23septt/Seismoguard/wiki/log.md

# Wiki Activity Log

Chronological record of all Knowledge Architect operations.
Format: `YYYY-MM-DD — <action> — <target(s)> — <source>`

---

- 2026-04-14 — **Initialized** wiki structure (`/raw/`, `/wiki/`, `index.md`, `log.md`) — system bootstrap.
- 2026-04-14 — **Ingested raw artifacts** into `/raw/`: `param_test.js`, `earthquake.ino`, `simulation.ino`, `flowchart_system.png`. Skipped `unpacked/word/document.xml` per user instruction (treated as outdated). — source: project root.
- 2026-04-14 — **Wrote synthesis** `raw/critique_future_work_2026-04-14.md` capturing fresh limitations & future-work bullets supplied by the user (not from the report). — source: chat synthesis.
- 2026-04-14 — **Wrote synthesis** `raw/grid_search_top10_2026-04-14.md` capturing the verbatim grid-search Top-10 table. — source: prior chat run of `param_test.js`.
- 2026-04-14 — **Created** [[STA/LTA Recursive Algorithm]] (`sta-lta-recursive-algorithm.md`) — source: /raw/earthquake.ino, /raw/param_test.js, /raw/grid_search_top10_2026-04-14.md.
- 2026-04-14 — **Created** [[STEAD Dataset]] (`stead-dataset.md`) — source: /raw/grid_search_top10_2026-04-14.md, /raw/critique_future_work_2026-04-14.md.
- 2026-04-14 — **Created** [[Grid Search Optimization]] (`grid-search-optimization.md`) — source: /raw/grid_search_top10_2026-04-14.md, /raw/param_test.js.
- 2026-04-14 — **Created** [[MPU6050 Sensor]] (`mpu6050-sensor.md`) — source: /raw/earthquake.ino, /raw/critique_future_work_2026-04-14.md.
- 2026-04-14 — **Created** [[Characteristic Function (Z-axis)]] (`characteristic-function.md`) — source: /raw/earthquake.ino, /raw/grid_search_top10_2026-04-14.md.
- 2026-04-14 — **Created** [[State Machine]] (`state-machine.md`) — source: /raw/earthquake.ino, /raw/flowchart_system.png.
- 2026-04-14 — **Created** [[Spike Rejection]] (`spike-rejection.md`) — source: /raw/earthquake.ino, /raw/grid_search_top10_2026-04-14.md.
- 2026-04-14 — **Created** [[Project — Earthquake Early Warning Device]] (`project-eew-device.md`) — source: aggregate of /raw/.
- 2026-04-14 — **Created** [[Future Work & Limitations]] (`future-work-limitations.md`) — source: /raw/critique_future_work_2026-04-14.md.
- 2026-04-14 — **Updated** `index.md` to list all 9 atomic pages under their categories.
- 2026-04-15 — **Replaced** `unpacked/word/document.xml` Chapter 5 body (~18.6 KB old) with new content (~19.8 KB) aligned to STEAD+Grid Search results; 21 paragraphs covering สรุปผล, อภิปรายผล (3 headline weaknesses), ข้อเสนอแนะ (5 priorities). Repacked → `รูปเล่มโครงงานเสด_new.docx` (1,760,786 bytes). — source: wiki/future-work-limitations.md, raw/grid_search_top10_2026-04-14.md.
- 2026-04-14 — **Replaced** `unpacked/word/document.xml` sections 2.2.1 and 2.2.2 (old bullet-list style, ~102 KB) with new structured narrative paragraphs (งานวิจัยที่ 1–8, ~31 KB) generated by `build_ch2.js`; repacked → `รูปเล่มโครงงานเสด_new.docx` (1,758,189 bytes). Papers: TH-1 เจริญยุทธ 2550, TH-2 Pananont 2560, TH-3 ชุมชน EEW 2564, FN-4 Won BLESeis 2020, FN-5 Sianturi Arduino MPU6050 2024, FN-6 Mousavi STEAD 2019, FN-7 Mousavi EQTransformer 2020, FN-8 Temneanu Self-Contained 2025.
- 2026-04-14 — **Edited** `unpacked/word/document.xml`: replaced old sections 3.2.6 (threshold test) and 3.2.7 (physical sensitivity test) with new sections 3.2.6 (STA/LTA Recursive algorithm design), 3.2.7 (STEAD data preparation), 3.2.8 (Grid Search optimization). Repacked → `รูปเล่มโครงงานเสด.docx` (1,766,629 bytes).
- 2026-04-15 — **Created** [[IPST Formatting Rules]] (`formatting-ipst-sswt.md`) summarising all สสวท. layout rules from `แบบฟอร์มวิจัย.pdf` (margins, fonts, spacing, page numbers, captions). — source: แบบฟอร์มวิจัย.pdf.
- 2026-04-18 — **Fixed Ch3 equations** via `fix_ch3_equations_v3.js` + `fix_alpha_formula.js`: (1) deleted unused v_y definition paragraph; (2) changed v_x OMML → v̄_z with overline accent; (3) corrected v_z definition text (was "CF = ผลต่างยกกำลังสอง" → "ค่าความเร่งแกน Z อินพุต"); (4) aligned step-3.2.6 step-1 notation (az → v_z/v̄_z); (5) updated STA/LTA recursive formula notation to STA(n)=α·CF(n)+(1−α)·STA(n−1); (6) corrected alpha formula from 1−exp(−1/τ) → 1/(τ·f_s) = 0.04/0.000667 matching firmware. Repacked → `รูปเล่มโครงงานเสด_new.docx` (1,849,500 bytes).
- 2026-04-15 — **Applied formatting** to `unpacked/word/document.xml` + `styles.xml` via `apply_format.js`: (1) page margins all 9 sectPr → left=2160 top=2160 right=1440 bottom=1440 twips; (2) docDefaults paragraph spacing → single (line=240, after=0); (3) Normal style pPr spacing explicit; (4) Normal style rFonts cs=TH Sarabun New added; (5) docDefaults rPrDefault sz 22→32 (16 pt). Repacked → `รูปเล่มโครงงานเสด_new.docx` (1,849,343 bytes).
- 2026-04-18 — **Created** `roc_analysis.js`: sweeps RATIO 10.0→1.5 (86 points), computes TPR/FPR/F1/AUC on STEAD 77P+38N; outputs ASCII ROC plot + `roc_data.csv`. AUC=0.9737; best operating point RATIO=5.0 (TPR=100%, FPR=3%, F1=0.994, avgDelay=11.1 samples). — source: param_test.js logic, seismoguard_data.json.
- 2026-04-18 — **Created** `adaptive_threshold.js`: Percentile Adaptive Threshold (PAT) benchmark vs fixed RATIO=5.0. PAT params: QUIET_BUF=200, PERC_Q=0.99, PERC_K=2.0, BASE=3.0. Cold-start results: Fixed TPR=100%/FPR=3%/F1=0.994; PAT TPR=36%/FPR=0%/F1=0.533. Documents warm-start advantage and ESP32 firmware hint. — source: roc_analysis.js, seismoguard_data.json.
- 2026-04-18 — **Created** `pd_magnitude.js`: Pd peak-displacement magnitude estimation on 77 P-wave waveforms. Pipeline: 3s window → detrend → integrate (trapezoidal) → detrend linear → integrate → peak abs disp → Wu & Kanamori (2005) log10(M)=1.0×log10(Pd)+5.39. Results: Mw range 3.34–8.88, median 5.20. — source: seismoguard_data.json, Wu & Kanamori 2005.
- 2026-04-18 — **Created** `seismoguard_esp32.ino`: full ESP32 port with (1) 50Hz hardware timer ISR; (2) WiFi connect; (3) HTTPS LINE Notify alert with Mw estimate; (4) Pd buffer 150×float; (5) local buzzer/LED; (6) 30s alert cooldown; (7) heartbeat serial monitor. Algorithm identical to Arduino version (τ_STA=0.5s, RATIO=5.0, MIN=10, SPIKE=100). — source: earthquake.ino, pd_magnitude.js.
- 2026-04-18 — **Created** [[ROC Analysis]] (`roc-analysis.md`). — source: roc_analysis.js output.
- 2026-04-18 — **Created** [[Adaptive Threshold]] (`adaptive-threshold.md`). — source: adaptive_threshold.js.
- 2026-04-18 — **Created** [[Pd Magnitude Estimation]] (`pd-magnitude.md`). — source: pd_magnitude.js, Wu & Kanamori 2005.
- 2026-04-18 — **Created** [[ESP32 LINE Notify Firmware]] (`esp32-line-notify.md`). — source: seismoguard_esp32.ino.
- 2026-04-18 — **Updated** `index.md`: added 3 algorithm pages (ROC, Adaptive Threshold, Pd) + 1 hardware page (ESP32 LINE Notify) under correct categories.
- 2026-04-19 — **Upgraded** `adaptive_threshold.js` → v2: added "preload pass" — silently scan first 50 pre-onset samples to populate quiet buffer before detection loop, fixing cold-start TPR (was 36% in v1). Swept PERC_K 1.0→2.5; best trade-off: PERC_K=1.2 (TPR=84%/FPR=3%/F1=0.909) or PERC_K=1.5 (TPR=74%/FPR=0%/F1=0.851) for zero-FP urban deployment. — source: seismoguard_data.json.
- 2026-04-19 — **Updated** [[Adaptive Threshold]] (`adaptive-threshold.md`): replaced v1 single-row result table with full v2 PERC_K sweep table (16 rows), added v1→v2 comparison, updated recommended PERC_K 2.0→1.5, corrected firmware hint multiplier. — source: adaptive_threshold.js v2 output.
- 2026-04-19 — **Created** `adaptive_sweep2d.js`: 3-D grid search QUIET_BUF_SIZE×PERC_K×PERC_Q (6×16×3=288 combos). Key finding: QUIET_BUF_SIZE=25 (matches 50-sample preload → fully populated ×2) improves best cold-start F1 from 0.909 → **0.939** (TPR=90%/FPR=3%) and best zero-FP F1 from 0.851 → **0.900** (TPR=82%). Recommended params: bufSize=25, PQ=0.99, PK=1.1. — source: seismoguard_data.json.
- 2026-04-19 — **Updated** [[Adaptive Threshold]] (`adaptive-threshold.md`): added 2D-sweep results table, buffer-size insight, updated firmware snippet (bufSize 200→25, PK 1.5→1.1, memory 400B→50B). — source: adaptive_sweep2d.js output.
- 2026-04-19 — **Re-validated all algorithms** on stratified dataset (200P+100N, Mw bins 3–4/4–5/5–6/6+ × 50 each). ROC: AUC=0.9689 (was 0.9737), RATIO=5.0 → TPR=94%/FPR=1%/F1=0.964/delay=14.7smp. PAT 2D sweep: best zero-FP = bufSize=50/PQ=0.99/PK=1.1 → TPR=82%/F1=0.898. — source: roc_analysis.js, adaptive_sweep2d.js, adaptive_threshold.js.
- 2026-04-19 — **Updated** `seismoguard.html`: ROC stats (AUC 0.9737→0.9689, TPR 100%→94%, FPR 3%→1%, F1 0.994→0.964, delay 11.1→14.7 smp), dataset counts (77→200 P-wave, 38→100 noise, label counters updated).
- 2026-04-19 — **Updated** `roc_analysis.js` + `adaptive_threshold.js`: comments N_PWAVE 77→200, N_NOISE 38→100; adaptive conclusion updated to PERC_K=1.1 bufSize=50.
- 2026-04-19 — **Updated** [[ROC Analysis]] (`roc-analysis.md`): full new results table, old-vs-new comparison, updated interpretation.
- 2026-04-19 — **Updated** [[Adaptive Threshold]] (`adaptive-threshold.md`): new 2D benchmark table (bufSize=50 confirmed optimal), firmware buf 25→50 (100 bytes DRAM).
- 2026-04-19 — **Updated** `index.md`: STEAD, ROC, Adaptive Threshold entries reflect stratified 200+100 dataset.
- 2026-04-19 — **Re-ran grid search** (`param_test.js`) on 200P+100N stratified dataset. Expanded grid: STA∈[0.2–0.6], RATIO∈[3.0–6.0], MIN∈[3–15], SPIKE∈[20–200] = 980 combos. New optimal: RATIO=4.0, MIN=5, SPIKE=50, STA=0.5s → TPR=96%/FPR=2%/F1=0.972/delay=9.6smp (vs old: 94%/1%/0.964/14.7smp). F1 +0.008, delay -5.1 samples.
- 2026-04-19 — **Updated firmware params** in `earthquake.ino` + `seismoguard_esp32.ino`: RATIO 5.0→4.0, MIN_TRIG 10→5, SPIKE 100→50.
- 2026-04-19 — **Updated** `seismoguard.html`: slider defaults (RATIO 5.0→4.0, MIN 10→5, SPIKE 100→50), JS _defaults(), ROC stats (TPR 94%→96%, FPR 1%→2%, F1 0.964→0.972, delay 14.7→9.6 smp).
- 2026-04-19 — **Implemented 2-tier alert** in `earthquake.ino` + `seismoguard_esp32.ino`: added MW_ALERT_LOCAL=4.5 / MW_ALERT_LINE=5.0 thresholds; added Pd estimation to Arduino (75-sample in-place buffer, 300 bytes SRAM); sub-threshold Mw<4.5 detected silently, no buzzer; LINE notify only at Mw≥5.0 with urgency-scaled message (5.0, 5.5, 6.0 tiers).
- 2026-04-19 — **Restructured** `stead_extractor.py` MW bins to align with alert tiers: sub(3–4.5)×100, T1(4.5–5)×100, T2(5–6.5)×200, crit(6.5+)×100 = 500P + 250N.
- 2026-04-19 — **Created** `stead_extractor.py`: Kaggle notebook to re-extract seismoguard_data.json from STEAD. Fixes: (1) Z-axis only data[:,2] not vector magnitude; (2) downsample 100→50 Hz via [::2]; (3) correct window sizes P=300 (50+250), Noise=2000 (1750+250); (4) JSON output not Arduino arrays. Dataset: https://www.kaggle.com/datasets/isevilla/stanford-earthquake-dataset-stead
- 2026-04-20 — **Updated** `stead_extractor.py`: restructured MW_BINS to 500P target aligned to 2-tier alert (sub 3–4.5×100, T1 4.5–5×100, T2 5–6.5×200, crit 6.5+×100) + N_NOISE=250. Removed legacy N_PWAVE/N_NOISE=100 constants. Ran on Kaggle → got 439P (crit bin limited to 39 by STEAD coverage) + 250N.
- 2026-04-20 — **Re-ran grid search** (`param_test.js`) on 439P+250N stratified dataset. New optimal: RATIO=6.0, MIN=3, SPIKE=50, STA=0.5s → TPR=100%/FPR=1%/F1=0.995/delay=11.6smp (vs old 200P+100N: 96%/2%/0.972/9.6smp).
- 2026-04-20 — **Re-ran ROC analysis** (`roc_analysis.js`) on 439P+250N. AUC=0.9919 (was 0.9689). RATIO=6.0 operating point: TPR=100%/FPR=1%/F1=0.994/delay=17.4smp (ROC sweep). Best F1=0.994 at RATIO=5.7.
- 2026-04-20 — **Re-ran adaptive sweep** (`adaptive_sweep2d.js`) on 439P+250N. Best zero-FP: bufSize=25/PQ=0.99/PK=1.2 → TPR=89%/F1=0.941. Best FPR≤3%: bufSize=25/PQ=0.95/PK=1.2 → TPR=94%/F1=0.964.
- 2026-04-20 — **Updated firmware params** in `earthquake.ino` + `seismoguard_esp32.ino`: RATIO 4.0→6.0, MIN_TRIG 5→3.
- 2026-04-20 — **Updated** `seismoguard.html`: dataset counts (200P→439P, 100N→250N), ROC stats (AUC 0.9689→0.9919, TPR 96%→100%, FPR 2%→1%, F1 0.972→0.995, delay 9.6→11.6smp), slider defaults (RATIO 4.0→6.0, MIN 5→3).
- 2026-04-20 — **Updated** [[ROC Analysis]] (`roc-analysis.md`): new results table, comparison v1/v2/v3 dataset, updated deployed RATIO 5.0→6.0.
- 2026-04-20 — **Updated** [[Adaptive Threshold]] (`adaptive-threshold.md`): new 439P+250N benchmark table, best bufSize 50→25, zero-FP F1 0.898→0.941, firmware snippet updated.
- 2026-04-20 — **Fixed** `adaptive_sweep2d.js` + `adaptive_threshold.js` + `roc_analysis.js`: updated MIN_TRIG 10→3, SPIKE 100→50 to match grid-search optimal. Re-ran all three. New adaptive sweep results: zero-FP best = bufSize=200/PQ=0.95/PK=1.6 → TPR=85%/F1=0.917; best FPR≤4% = bufSize=25/PQ=0.99/PK=1.1 → TPR=93%/F1=0.958.
- 2026-04-20 — **Fixed** `param_test.js` comment: "200P+100N" → "439P+250N", updated previous-defaults comparison to RATIO=4.0/MIN=5/SPIKE=50.
- 2026-04-20 — **Rewrote** [[Grid Search Optimization]] (`grid-search-optimization.md`): replaced 77P+38N era top-10 table with v3 (439P+250N) top-10, version history table, caveats updated.
- 2026-04-20 — **Updated** [[Adaptive Threshold]] (`adaptive-threshold.md`): PERC_K sweep table rewritten with 439P+250N results; 2D-sweep best params updated (zero-FP: bufSize=200/PK=1.6/PQ=0.95 → F1=0.917); firmware snippet updated.
- 2026-04-20 — **Updated** [[STA/LTA Recursive Algorithm]] (`sta-lta-recursive-algorithm.md`): operating params RATIO 5.0→6.0, MIN 10→3, added SPIKE=50, F1 updated to 0.995. — source: grid search v3.
- 2026-04-20 — **Updated** [[ESP32 LINE Notify Firmware]] (`esp32-line-notify.md`): params table RATIO 5.0→6.0, MIN_TRIG 10→3, SPIKE 100→50; AUC 0.9737→0.9919; serial output RATIO updated; differences table Pd/2-tier rows updated. — source: seismoguard_esp32.ino v3.
- 2026-04-20 — **Rewrote** [[STEAD Dataset]] (`stead-dataset.md`): v3 dataset table (sub×100, T1×100, T2×200, crit×39, Noise×250), version history v1/v2/v3, Pd overestimation limitation noted. — source: stead_extractor.py output.
- 2026-04-20 — **Rewrote** [[Project — Earthquake Early Warning Device]] (`project-eew-device.md`): pipeline SPIKE 100→50; per-bin detection table (all 4 Mw bins); Pd per-bin validation table; critical limitation (91% sub-bin overestimate) documented. — source: roc_analysis.js, pd_magnitude.js v3.
- 2026-04-21 — **Rewrote Ch4 sections 4.4–4.7** in `รูปเล่มโครงงานเสด_new.docx` via `build_ch4.js` (88 KB new, replacing 37 KB old): 4.4 Grid Search v3 top-10 table (RATIO=6.0/MIN=3/SPIKE=50, F1=0.995, 980 combos, 677,220 sims); 4.5 ROC Analysis AUC=0.9919 key-points table; 4.6 Pd per-bin estimation table (crit 97% correct, sub 79% overestimate); 4.7 2-tier alert summary table. XML-escaped all < > & in table cells. — source: grid-search-optimization.md, roc-analysis.md, project-eew-device.md.
- 2026-04-21 — **Updated Ch5 body** in `รูปเล่มโครงงานเสด_new.docx` via `build_ch5_v2.js` (21 KB new, replacing 69 KB old): 5.1 results updated (77/77→439/439, 225→980 combos, RATIO=5.0→6.0, MIN=10→3, SPIKE=100→50, delay 11.1→11.6smp, FP 1/38→3/250 1%, AUC=0.9919 added, Pd limitation added); 5.2 discussion updated (Spike factor 100→50, MIN 10→3, FPR 2.6→1%, single-station limitation added); 5.3 recommendations reordered (field test first priority, Pd calibration added as req. 2). — source: all v3 results.
- 2026-04-21 — **Updated Ch3 Grid Search paragraphs** in `รูปเล่มโครงงานเสด_new.docx`: para-1 (search space 225→980 combos, STEAD 115→689 traces, 25,875→677,220 simulations); para-2 (best params RATIO=5.0→6.0, MIN=10→3, SPIKE=100→50, delay 11.1→11.6smp, FA 1/38 2.6%→3/250 1%, F1=0.995 added). — direct XML replacement at para offsets 381037–383579.
- 2026-04-21 — **Updated Ch2 STEAD references** (×2) in `รูปเล่มโครงงานเสด_new.docx`: (1) section 2.1.6 STEAD description: 77P+38N→439P+250N, 25,875→677,220 sims via `fix_ch2_stead.js`; (2) literature review paper-6 summary paragraph: same values plus Stratified Mw bins added via `fix_ch2_stead2.js`. All v1 data (25,875, 77/77, 1/38 2.6%, MIN=10, SPIKE=100, 225 combos) now completely removed from the document. Final doc size: 875,515 bytes.
- 2026-04-21 — **Replaced Pd-based tier logic with peak STA/LTA ratio-based tier logic** in both firmware files. Root cause: MPU6050 noise floor ~400× higher than broadband seismometers; double integration amplifies noise until it exceeds real signal displacement for Mw <5 events — Pd estimate is unreliable. Fix: use peakRatio (max STA/LTA during ALARMING window) as shaking-intensity proxy — already computed, no integration needed, self-normalized to local noise. Changes: (1) `raw/earthquake.ino`: removed MW_ALERT_LOCAL, PD_SAMPLES, MPU_SCALE_CMS2, WK_INTERCEPT, pdBuf[75] (freed 300 bytes SRAM), pdIdx, pdCollecting, computeMw(); added RATIO_TIER1=8.0f, peakRatio global, immediate arming when peakRatio >= RATIO_TIER1; (2) `seismoguard_esp32.ino`: removed MW_ALERT_LOCAL + MW_ALERT_LINE, added RATIO_TIER1=8.0f + RATIO_TIER2=25.0f, added peakRatio + lineSent globals, Tier-1 and Tier-2 fire immediately (no 3s wait), kept computeMw() for informational Serial.printf logging only. RATIO_TIER1/TIER2 are initial estimates — require field calibration with real earthquake data.
