23septt/Seismoguard/CDT2026/seismoguard_uno_q/tests/fixtures/synthetic_pwave.csv

# synthetic P-wave-like waveform | 100 Hz | 5 s total
# format: ax_mss | ay_mss | az_mss
# 100 quiet samples (1 s) | then 400 samples (4 s) of damped 3 Hz envelope on Z
0.0 | 0.0 | 9.81
0.0 | 0.0 | 9.81
0.0 | 0.0 | 9.81
0.0 | 0.0 | 9.81
0.0 | 0.0 | 9.81
0.0 | 0.0 | 9.81
0.0 | 0.0 | 9.81
0.0 | 0.0 | 9.81
0.0 | 0.0 | 9.81
0.0 | 0.0 | 9.81
0.0 | 0.0 | 9.81
0.0 | 0.0 | 9.81
0.0 | 0.0 | 9.81
0.0 | 0.0 | 9.81
0.0 | 0.0 | 9.81
0.0 | 0.0 | 9.81
0.0 | 0.0 | 9.81
0.0 | 0.0 | 9.81
0.0 | 0.0 | 9.81
0.0 | 0.0 | 9.81
0.0 | 0.0 | 9.81
0.0 | 0.0 | 9.81
0.0 | 0.0 | 9.81
0.0 | 0.0 | 9.81
0.0 | 0.0 | 9.81
0.0 | 0.0 | 9.81
0.0 | 0.0 | 9.81
0.0 | 0.0 | 9.81
0.0 | 0.0 | 9.81
0.0 | 0.0 | 9.81
0.0 | 0.0 | 9.81
0.0 | 0.0 | 9.81
0.0 | 0.0 | 9.81
0.0 | 0.0 | 9.81
0.0 | 0.0 | 9.81
0.0 | 0.0 | 9.81
0.0 | 0.0 | 9.81
0.0 | 0.0 | 9.81
0.0 | 0.0 | 9.81
0.0 | 0.0 | 9.81
0.0 | 0.0 | 9.81
0.0 | 0.0 | 9.81
0.0 | 0.0 | 9.81
0.0 | 0.0 | 9.81
0.0 | 0.0 | 9.81
0.0 | 0.0 | 9.81
0.0 | 0.0 | 9.81
0.0 | 0.0 | 9.81
0.0 | 0.0 | 9.81
0.0 | 0.0 | 9.81
0.0 | 0.0 | 9.81
0.0 | 0.0 | 9.81
0.0 | 0.0 | 9.81
0.0 | 0.0 | 9.81
0.0 | 0.0 | 9.81
0.0 | 0.0 | 9.81
0.0 | 0.0 | 9.81
0.0 | 0.0 | 9.81
0.0 | 0.0 | 9.81
0.0 | 0.0 | 9.81
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
