23septt/Seismoguard/Data/roc_results.csv

ratio | tpr | fpr | precision | f1 | tp | fp | avg_delay_samples
10.0 | 0.9841 | 0.0080 | 0.9954 | 0.9897 | 432 | 2 | 15.52
9.9 | 0.9841 | 0.0080 | 0.9954 | 0.9897 | 432 | 2 | 15.43
9.8 | 0.9841 | 0.0080 | 0.9954 | 0.9897 | 432 | 2 | 15.18
9.7 | 0.9841 | 0.0080 | 0.9954 | 0.9897 | 432 | 2 | 15.09
9.6 | 0.9841 | 0.0080 | 0.9954 | 0.9897 | 432 | 2 | 14.87
9.5 | 0.9841 | 0.0080 | 0.9954 | 0.9897 | 432 | 2 | 14.42
9.4 | 0.9841 | 0.0080 | 0.9954 | 0.9897 | 432 | 2 | 14.19
9.3 | 0.9841 | 0.0080 | 0.9954 | 0.9897 | 432 | 2 | 14.12
9.2 | 0.9841 | 0.0080 | 0.9954 | 0.9897 | 432 | 2 | 14.02
9.1 | 0.9841 | 0.0080 | 0.9954 | 0.9897 | 432 | 2 | 13.93
9.0 | 0.9841 | 0.0080 | 0.9954 | 0.9897 | 432 | 2 | 13.82
8.9 | 0.9841 | 0.0080 | 0.9954 | 0.9897 | 432 | 2 | 13.70
8.8 | 0.9841 | 0.0080 | 0.9954 | 0.9897 | 432 | 2 | 13.60
8.7 | 0.9863 | 0.0080 | 0.9954 | 0.9908 | 433 | 2 | 13.86
8.6 | 0.9863 | 0.0080 | 0.9954 | 0.9908 | 433 | 2 | 13.77
8.5 | 0.9863 | 0.0080 | 0.9954 | 0.9908 | 433 | 2 | 13.69
8.4 | 0.9863 | 0.0080 | 0.9954 | 0.9908 | 433 | 2 | 13.63
8.3 | 0.9863 | 0.0080 | 0.9954 | 0.9908 | 433 | 2 | 13.55
8.2 | 0.9863 | 0.0080 | 0.9954 | 0.9908 | 433 | 2 | 13.45
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
