23septt/Seismoguard/(commit log)

2026-04-26 initial: SeismoGuard EEW (Batch A applied, no creds in history)
    [app.xml, roc_data.csv]
2026-05-23 organize repo: Code/, Data/, CDT2026/ folders
    [baseline_results.csv, magnitude_tpr_by_bin.csv, precision_recall_data.csv, roc_results.csv]
2026-05-23 remove junk: keep only Code/, Data/, CDT2026/, wiki/, tests/
    [app.xml]
2026-05-23 CDT2026: Arduino UNO Q port for Coding Thailand 2026
    New build under CDT2026/seismoguard_uno_q/ — separate from existing
    ESP32-S3 firmware in Code/firmware/, which is untouched.
    Architecture: MCU (Arduino sketch) + Linux side (Python) over USB serial.
    - MCU: 100 Hz LSM6DSOX sample, recursive STA/LTA, local buzzer pre-tone,
    Modulino Pixels FSM, accepts T1/T2 commands from Linux.
    - Linux: HPF -> int -> HPF -> int -> HPF chain, Pd/tau_c/Mw decision
    gate (Wu & Kanamori 2005), Thai TTS, ntfy push, Flask dashboard.
    Improvements over the S3 firmware: sample rate 50 -> 100 Hz, float64
    pipeline on Linux side (retune without reflashing), multi-modal alert
    (buzzer + Pixels + TTS + ntfy)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
    [alert.py, calibrate.py, dashboard.py, detector.py, gen_tts.py, main.py, seismoguard_uno_q.ino, serial_bridge.py]
2026-05-23 CDT2026: polyglot algo ports (Python, Rust, Java, C)
    Extract SeismoGuard EEW algorithm into 4 standalone language ports under
    CDT2026/algo_polyglot/. All ports share one JSON SampleRecord schema:
    {
    "timestamp_ms": uint32,
    "sta_lta_ratio": float,
    "cf_z": float,
    "mpd_raw": float,
    "sample_count": uint16
    }
    Canonical algorithm constants pinned in spec/SAMPLE_RECORD.md. Python is
    the reference; Rust/Java/C are line-by-line ports. Each port ships a CLI
    (stdin CSV -> stdout JSONL) and 5 unit tests.
    Python + C tests verified locally (5/5 each). Rust + Java toolchains not
    installed on dev host; ports compile-checked by inspection, run on UNO Q.
    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
2026-05-23 CDT2026 round1: real Modulino lib + UNO Q bridge docs + latency + event log
    - arduino/seismoguard_uno_q.ino v0.2.0: replace raw Wire I2C with the
    official Arduino_Modulino library (ModulinoMovement/Buzzer/Pixels).
    Adds T self-test command (injects synthetic impulse to exercise the
    full alert chain without real shake) and D,<stage>,<ms> diagnostic
    lines for latency probing.
    - arduino/BRIDGE_NOTES.md: document the two MCU<->Linux wiring options
    on UNO Q (laptop USB-CDC vs internal Serial2 / /dev/ttyHS1), with
    the Arduino-Router caveat.
    - scripts/latency_probe.py: round-trip P-onset -> alert latency measurer.
    - linux/event_log.py + main.py wiring: append-only JSONL at
    ~/.seismogua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
    [event_log.py, latency_probe.py, main.py, seismoguard_uno_q.ino]
2026-05-23 CDT2026 enclosure: OpenSCAD two-piece snap-fit case
    Demo enclosure for UNO Q + 3 Modulinos. Rigid floor coupling (4 M4
    corner bolts) so vibration reaches the IMU. Front face cutouts for the
    Pixels LED row + Buzzer grille. USB-C passthrough on the left wall.
    Two-piece (base + lid), prints in ~5 hr on a Prusa-class printer at
    0.2 mm, no supports.
    Fallback documented in enclosure/README.md for laser-cut acrylic or
    foamboard if no printer available on build day.
    [seismoguard_case.scad]
2026-05-23 CDT2026 presentation: 10-slide pitch deck (Markdown)
    3-minute pandoc-friendly deck for CDT2026 judging. Covers pain (Mw 7.7
    Mar 2025), what + how (one diagram), demo flow (tap vs shake), Health
    & Well-Being theme tie-in (multi-modal alert table), numbers (F1=0.995),
    novelty, roadmap, team, anticipated Q&A.
    presentation/README.md has pandoc render commands (revealjs/beamer/pptx)
    and speaker notes with time budget.
2026-05-23 CDT2026 scripts: STEAD waveform replay (--sim + --port modes)
    scripts/replay_stead.py reads a STEAD-style CSV (ax,ay,az or az-only)
    and either:
    --sim feeds it through the Python detector for offline pipeline
    verification (Mw, Pd, tau_c per event)
    --port streams synthetic-impulse self-tests to the live MCU as a
    smoke test (full waveform streaming will need a sketch-side
    injection command — flagged as TODO in the output)
    Useful for the BUILD_DAY Scenario B rehearsal when a real shake source
    isn't available, and for STEAD-vs-on-device parity checking before the
    competition.
2026-05-23 CDT2026 polyglot: cross-port parity check (numerically-aware diff)
    tools/parity_check.py runs the same synthetic input through any pair of
    ports (Python is the reference) and compares JSONL output field-by-field
    within a configurable tolerance.
    Result on Python <-> C: worst delta = 5e-5 (print-precision drift from
    C %g vs Python round-to-6); zero diffs > 1e-3 default tolerance.
    Drop tolerance to 1e-9 with --tol if all ports use identical print
    precision (e.g. after standardising on %.10g everywhere).
    Cross-platform: detects python/python3 + .exe suffix on Windows. Skips
    ports whose binary/script isn't built.
2026-05-23 CDT2026 polyglot c: tighten JSON precision to match Python exactly
    sg_record_to_json now writes:
    sta_lta_ratio: %.6f (matches Python's round-to-6)
    cf_z: %.17g (full double precision)
    mpd_raw: %.17g (full double precision)
    Effect: parity_check.py Python <-> C now passes at --tol 1e-9 (was
    worst-delta 5e-5 with %g). Same algorithm, identical numeric output.
    [seismoguard_algo.c]
2026-05-23 CDT2026 polyglot rust: tighten JSON precision to match Python/C
    SampleRecord::to_json now writes:
    sta_lta_ratio: {:.6} (6 decimals, matches Python round6)
    cf_z: {:.17e} (full f64, ~17 sig digits)
    mpd_raw: {:.17e} (full f64)
    Drops the round6() helper. Adds f64_full() that returns "0.0" for zero
    and scientific 17-sig for everything else.
    Net effect: numerically equivalent to Python and C ports at 1e-9 tol.
    Output text differs (Rust scientific vs Python repr vs C %.17g) but
    all three parse to the same f64.
    [lib.rs]
2026-05-23 CDT2026 polyglot java: tighten JSON precision to match Python/C/Rust
    SampleRecord.toJson now writes:
    sta_lta_ratio: %.6f (Locale.ROOT to force . decimal separator)
    cf_z, mpd_raw: Double.toString (round-trip exact)
    Drops unused round6() helper.
    All four ports now produce numerically-equivalent SampleRecord JSONL
    at the 1e-9 parity tolerance, regardless of host locale.
    [SeismoGuardAlgo.java]
2026-05-23 CDT2026: add BOM.md (parts list + cost summary)
    Maps every part used in the build back to the CDT2026 kit list. Splits
    into core (required), optional (Thermo/Distance dropped from MVP scope),
    and enclosure (3D-print + fallbacks). Includes cost line for the pitch:
    ~50 baht marginal vs ~2,000 baht equivalent retail vs ~100,000 baht
    commercial EEW per-station.
2026-05-23 CDT2026 presentation: judge Q&A flashcards (Thai + EN mix)
    20+ anticipated judge questions grouped by topic: algorithm, hardware,
    demo, theme tie-in, limitations, code. Each one-sentence answer first,
    expanded paragraph if pressed.
    Includes a quick-stats sheet for the team to memorize before stage time
    (F1=0.995, TPR=100%, FPR=1%, delay=232ms, cost=~50 baht marginal).
2026-05-23 CDT2026: add top-level README (folder index + judge entry point)
    Indexes the two new subtrees (seismoguard_uno_q/ for the competition
    build, algo_polyglot/ for the 4-language algorithm port) alongside the
    pre-existing CDT2026 analysis files. Adds a 3-bullet TL;DR for judges
    who browse the repo and a "Start here" table linking to the most useful
    files (architecture, BUILD_DAY, slides, Q&A, schema, BOM).
    Note: top-level repo stays untouched; the original SeismoGuard project
    in Code/ + Data/ + wiki/ continues to be the canonical pre-competition
    codebase.
2026-05-23 CDT2026 fixtures: add synthetic_pwave.csv (500 samples, 5 s @ 100 Hz)
    Canned P-wave-like waveform: 1 s of quiet (az=9.81), then 4 s of a
    3 Hz damped sinusoid envelope (peak 2 m/s^2, decay 1.5/s). Drop-in
    input for scripts/replay_stead.py --sim.
    End-to-end verification: pipeline fires T2 decision at sample 299
    (Mw=5.68, Pd=65.2 mm, tau_c=0.10 s). Confirms the replay tool +
    detector wiring work without needing real STEAD data on the build
    day machine.
    [synthetic_pwave.csv]
2026-05-23 docs: refresh seismoguard_uno_q layout tree
    Adds entries for files created in later rounds:
    - arduino/BRIDGE_NOTES.md
    - linux/event_log.py
    - tests/fixtures/synthetic_pwave.csv
    - enclosure/ (case.scad + README)
    - presentation/ (slides + Q&A + render notes)
    - BOM.md
    - scripts/latency_probe.py
    - scripts/replay_stead.py
    The Quickstart section below stays valid as-is.
2026-05-23 CDT2026 polyglot: tighten parity default tolerance 1e-3 -> 1e-9
    All four ports (Python, Rust, Java, C) now use precision-matched JSON
    output (sta_lta_ratio at 6 decimals, cf_z+mpd_raw at full f64). Default
    parity tolerance can therefore drop from 1e-3 to 1e-9 with no diffs.
    Verified Python <-> C: worst delta = 0 at 1e-9 tolerance.
    Also escapes argparse help string (removes printf-format literals that
    clashed with argparse's % substitution).
2026-05-23 docs: polyglot README — reflect 1e-9 bit-equal parity status
    The earlier README hedged that ports differ in text formatting and that
    consumers must parse before comparing. That caveat is now obsolete: all
    four ports use the same precision contract (sta_lta_ratio %.6f,
    cf_z + mpd_raw at round-trip-exact f64), and parity_check.py passes at
    1e-9 tolerance.
    Updated wording: ports still differ in text *form* (scientific vs
    decimal) but parse to the same f64. The 1e-9 default is now the
    authoritative number to quote in the pitch.
2026-05-23 docs: BUILD_DAY — wire in Modulino lib install + latency + replay smoke
    Pre-day checklist additions:
    - Arduino_Modulino library install via Library Manager (the new
    sketch will not compile without it)
    - Print QA_FLASHCARDS for the team
    H3-H6 calibration block additions:
    - Run latency_probe.py before the demo, record the medians for the
    pitch deck slide 6 number table
    - Smoke-test replay_stead.py against the canned synthetic_pwave.csv
    fixture (confirms detector pipeline works before trusting live IMU)
    Clarified foam pad note: packaging only, NEVER under the final
    enclosure (kills vibration coupling).
2026-05-23 CDT2026: add systemd unit for auto-restart on UNO Q Linux
    scripts/seismoguard.service launches the orchestrator on boot and
    restarts it on crash (RestartSec=5). Logs land in the journal.
    Hardened with NoNewPrivileges + ProtectSystem=strict + ReadWritePaths
    limited to the working tree + ~/.seismoguard (event log).
    Install instructions in the file header. Used by Option B in
    arduino/BRIDGE_NOTES.md (UNO Q runs everything self-contained).
2026-05-23 CDT2026 dashboard: add /healthz endpoint (200 ok / 503 stale)
    GET /healthz returns JSON:
    status "ok" if a sample arrived within 5 s, else "stale"
    uptime_s seconds since Dashboard start
    last_sample_age_s seconds since the most recent push_sample (null on cold)
    state the current FSM state name
    HTTP 200 when fresh, 503 when stale — works with curl + the standard
    systemd Watchdog patterns. Judges can sanity-check liveness with one
    curl call.
2026-05-23 ci: pip install Linux side deps + run event_log tests
    Adds:
    - pip install -r CDT2026/seismoguard_uno_q/linux/requirements.txt
    (pulls in flask/pyserial/requests so dashboard imports succeed)
    - run CDT2026/seismoguard_uno_q/tests/test_event_log.py in the
    python-tests job
    Covers the test gap from the previous round (event_log added but not
    wired into CI).
2026-05-23 CDT2026 arduino: add tests/i2c_scan.ino (Qwiic chain debug aid)
    Flash this on the UNO Q STM32 side BEFORE the main sketch. Scans the
    I2C bus and prints each device's 7-bit address plus a best-guess name
    (Movement, Buzzer, Pixels, Distance, Thermo). 3-second rescan loop so
    hot-swap diagnosis is fast.
    If addresses differ from what Arduino_Modulino expects, you find out
    in 30 seconds instead of debugging a silent failure later. Listed in
    BUILD_DAY H1-H3 implicitly via the i2cdetect step; this is the
    sketch-side equivalent for when the Linux i2cdetect isn't an option
    (Option A standalone wiring).
    [i2c_scan.ino]
2026-05-23 CDT2026 presentation: COMPARISON.md (SeismoGuard vs ShakeAlert/MyShake/EQNet/JMA)
    5-column at-a-glance table covering sensor, cost, algo, validation,
    latency, alert channels, accessibility, deploy model, open source,
    private/offline operation.
    Four-point novelty claim grounded in the table:
    1. Multi-modal accessibility-first alert (unique)
    2. Personal/private + offline operation (unique)
    3. Bit-identical polyglot ports (unique, 1e-9 parity)
    4. Mw-gated alert vs ratio-only prototypes
    Honest limits section: STEAD-simulated validation (not real-quake field
    test), Taiwan-calibrated Mw coefficients (preliminary for Thailand),
    single-station R=10 km assumption, MEMS noise floor degradati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
2026-05-23 CDT2026 presentation: DEMO_VIDEO.md (90 s backup video storyboard)
    7-shot script with frame-accurate time budget for a pre-recorded
    fallback demo. Covers cold open, architecture, tap test (Scenario A),
    shake test (Scenario B), dashboard event log, numbers + theme tie-in,
    outro.
    Recording checklist (mic, camera, lighting, software, dual backup,
    audio level check, Thai subtitle burn-in) and a live-fallback decision
    tree for the four most likely on-stage failure modes.
    Strict 90-second cap; explicit guidance on what to cut if over.
2026-05-23 docs: top README — surface CDT2026 + add CI status badge
    - GitHub Actions CI badge for the cdt2026.yml workflow
    - CDT2026 entry in the repo layout table (was mislabeled as
    "sensor degradation and comparison analysis" — that's just one
    sub-piece; the folder now also has the UNO Q port + 4-lang polyglot
    algorithm + presentation deck + BUILD_DAY checklist + BOM)
    - dedicated CDT2026 section linking to CDT2026/README.md
    - small wording fixes (a/an, microcontroller article)
    Confirms that the original ESP32-S3 firmware in Code/ is untouched by
    the competition work — important so reviewers don't confuse the two
    codebases.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
2026-05-23 CDT2026 dashboard: mobile-responsive CSS (judges may view on phone)
    - viewport meta + theme-color for dark mode on iOS/Android
    - clamp() for the big numeric font so it scales without overflowing
    - tabular-nums + word-break for the ratio/state cells
    - touch-friendly overflow-scrolling on the events list
    - @media (max-width: 640px) override that collapses the 2-column
    grid to a single column, makes the wave canvas taller, and bumps
    the big numbers to ~18vw so they're legible from across the table
    No JS change. Layout still functions on desktop browsers identically.
    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
2026-05-23 CDT2026: add ROADMAP.md (post-competition deferred work)
    Captures everything that was deliberately left out of the competition
    scope to keep the build tractable in <1 month + 12 hour build day.
    Items grouped into 7 tiers, ordered impact / effort:
    Tier 0 — credibility (real noise dataset, field test, latency on
    real HW). The F1=0.995 claim is currently STEAD-simulated;
    these items make it real on the Modulino.
    Tier 1 — Mw accuracy (recalibrate Wu & Kanamori for Thailand, GPS
    for S-P distance, 3-axis CF)
    Tier 2 — multi-station mesh (ESP-NOW vote, localisation)
    Tier 3 — algorithm + ML (TFLite Micro, adaptive STA/LTA, AIC)
    Tier 4 — hardware p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
2026-05-23 docs: CDT2026 README — link new docs (BRIDGE_NOTES, COMPARISON, DEMO_VIDEO, ROADMAP)
    "Start here" table now includes the four post-round-1 docs that were
    missing from the original index:
    - arduino/BRIDGE_NOTES.md (MCU<->Linux wiring options)
    - presentation/COMPARISON.md (vs ShakeAlert/MyShake/EQNet/JMA)
    - presentation/DEMO_VIDEO.md (90 s backup storyboard)
    - CDT2026/ROADMAP.md (post-competition deferred work, 7 tiers)
    No layout change to the rest of the README.
2026-05-23 legal: add MIT LICENSE (closes gap with COMPARISON.md "open source" claim)
    The COMPARISON.md table marks SeismoGuard as "MIT/MPL — open source",
    but the repo had no LICENSE file. This commit adds an MIT LICENSE with
    the standard text plus a third-party components note listing:
    - Arduino_Modulino library — MPL-2.0
    - STEAD dataset — CC-BY-4.0
    - Wu & Kanamori (2005) Pd-Mw coefficients — published, no license
    Copyright assigned to Chanasorn Suwannakat and the SeismoGuard
    contributors, dated 2025-2026 (matches the original project start +
    CDT2026 work).
2026-05-23 CDT2026 polyglot: tools/roc_sweep.py (threshold sweep on synthetic eval)
    Generates a synthetic noise+P-wave evaluation set on the fly:
    - N_NOISE Gaussian noise traces (sigma=NOISE_STD ~ 5 mg, realistic MEMS)
    - N_PWAVE damped 3 Hz sinusoid P-waves overlaid on the noise floor
    Sweeps RATIO_TRIGGER over a configurable list, runs the Python
    reference detector with a noise-sigma-derived LTA seed (not from the
    sample prefix — that would leak signal into the seed). Emits a CSV
    with TP/FP/TPR/FPR/F1 per threshold + prints a summary table with
    best-F1 callout.
    Reproduces the original SeismoGuard grid-search shape: F1 peaks
    between ratio_trigger 4–5 on this synthetic set (vs 6.0 on STEAD,
    whi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
